nz-Mark-Y/line-following-robot/PCB Prototyping/ProposedCircuit.JPG

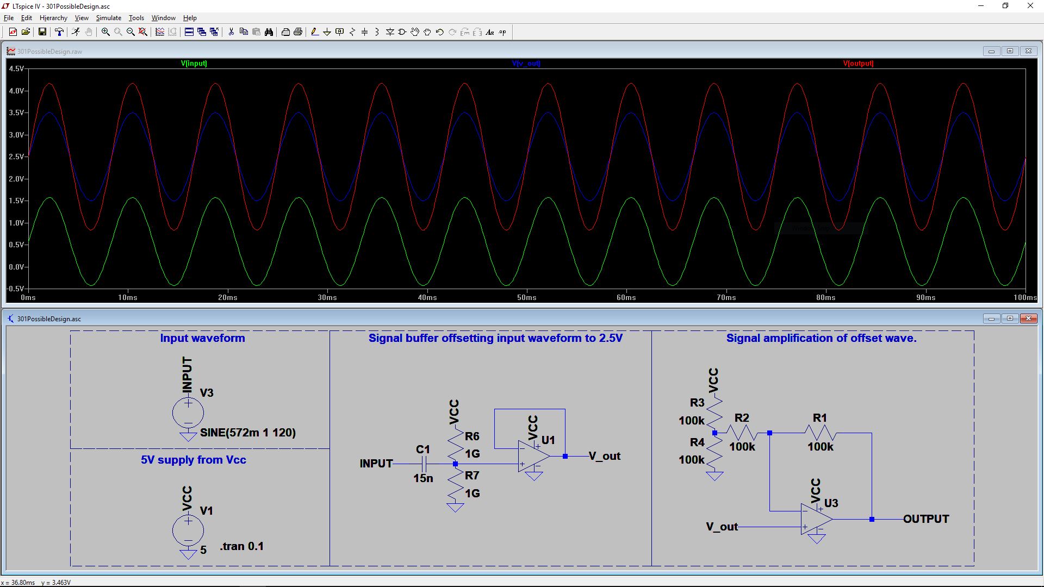
PCB Prototyping/ProposedCircuit.JPG
