nz-Mark-Y/line-following-robot/PCB Prototyping/Faulty Proposed Circuit.JPG

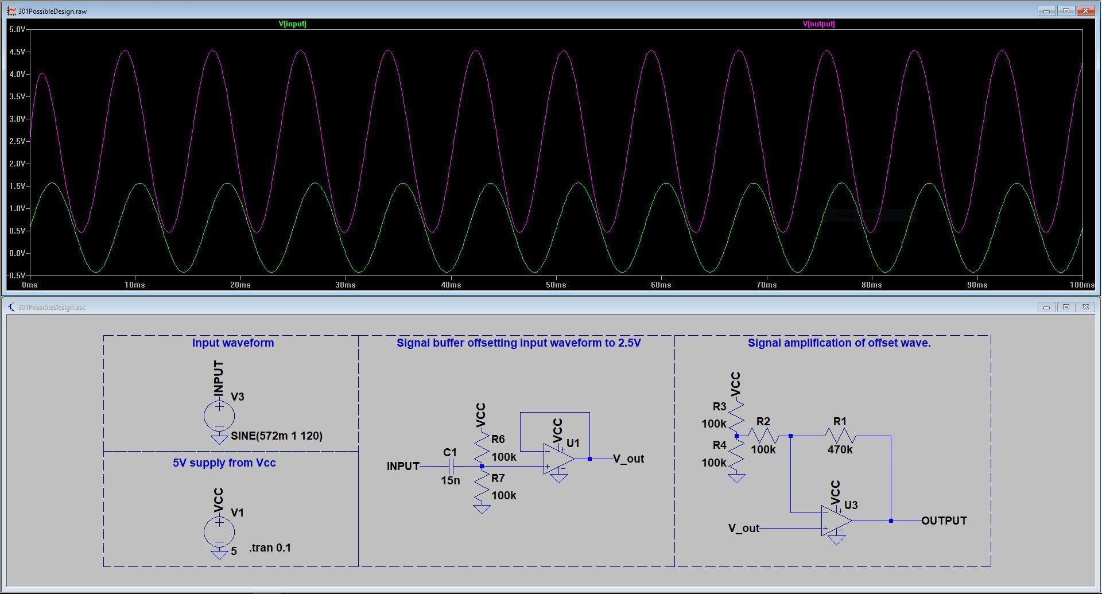
PCB Prototyping/Faulty Proposed Circuit.JPG
