nz-Mark-Y/line-following-robot/README.md

# README #

### What is this repository for? ###

* Line following robot with light sensing line tracking capabilities, to traverse a maze projected onto a surface.
* Prototype version complete

### Who do I talk to? ###

* Sylvain Bechet
* Savi Mohan
* Ira Syamira 
* Mark Yep
