nz-Mark-Y/line-following-robot/CS301_Class.cydsn/ComponentUpdateLog.txt

Last Modified Date & Time: 08/16/2017 14:08:49

CS301_Class: CS301_Class.cydwr
	cy_boot [v5.40] to [v5.60]
	LIN_Dynamic [v3.40] to [v4.0]

CS301_Class: TopDesign.cysch
	Timer_TS [v2.70] to [v2.80]
	USBUART [v3.0] to [v3.20]

Last Modified Date & Time: 08/18/2017 10:47:55

CS301_Class: TopDesign.cysch
	Timer_TS [v2.70] to [v2.70]
	USBUART [v3.0] to [v3.0]

CS301_Class: CS301_Class.cydwr
	cy_boot [v4.20] to [v5.40]
