nz-Mark-Y/line-following-robot/PCB Prototyping/Light Sensor PCB.PDF

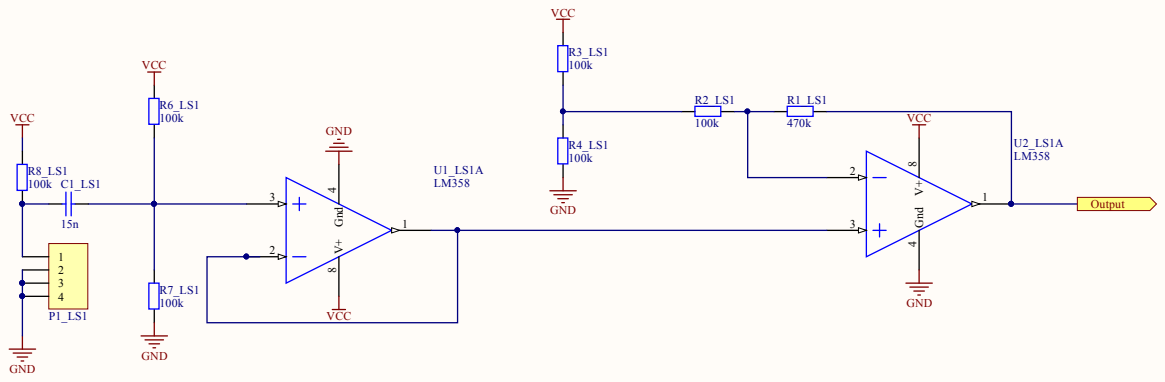
[picture p14: page 1]

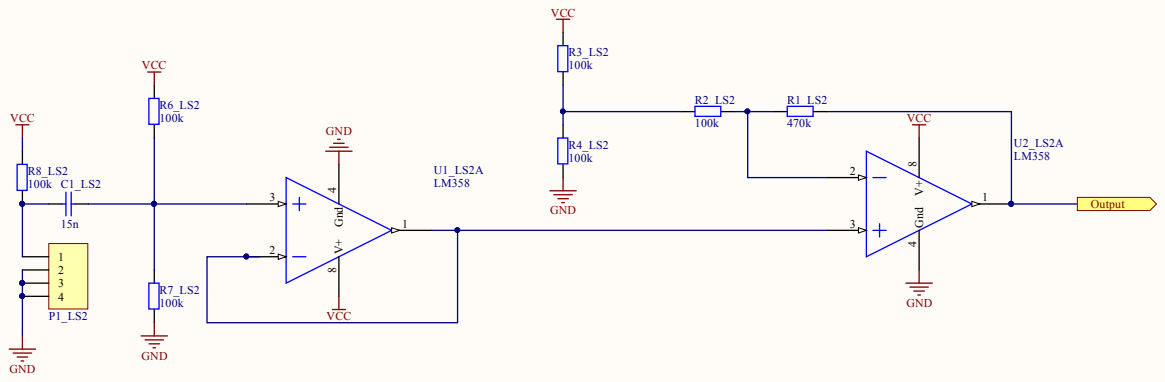
[picture p15: page 2]

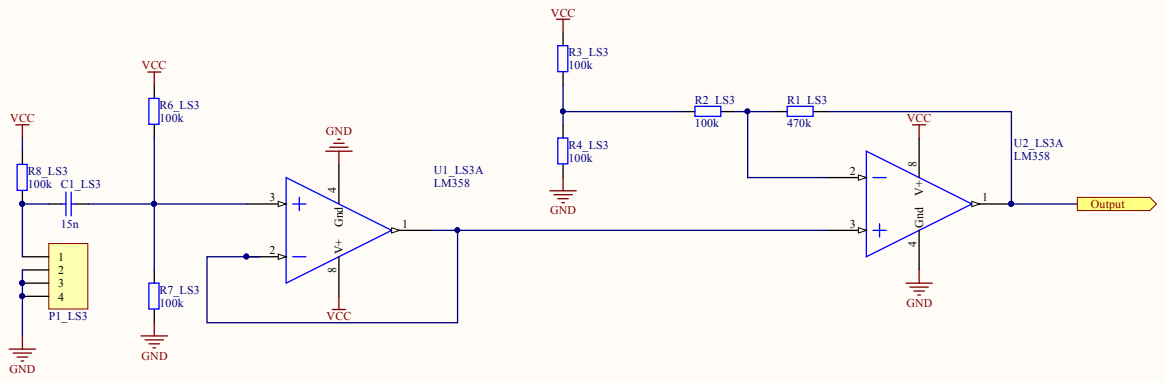
[picture p16: page 3]

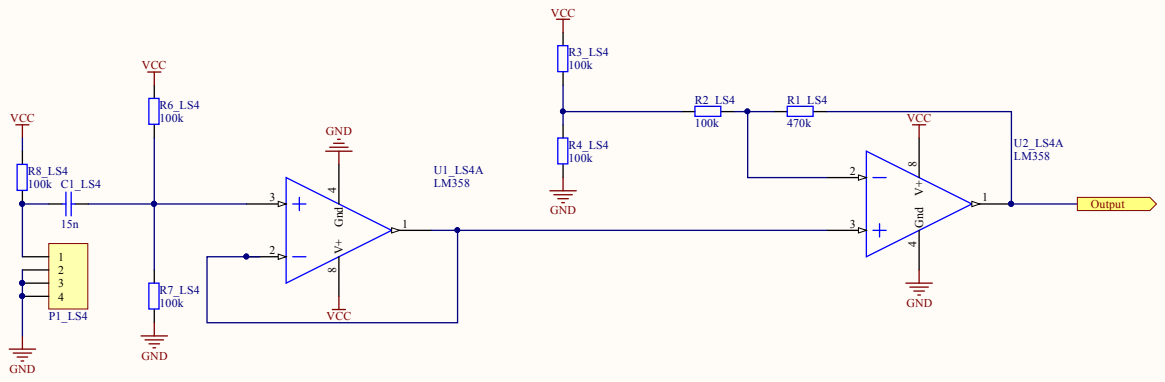
[picture p17: page 4]

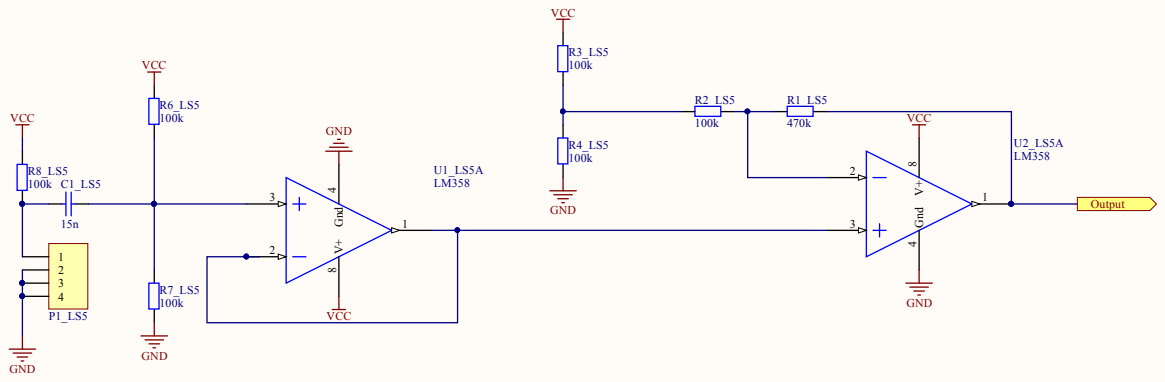
[picture p18: page 5]

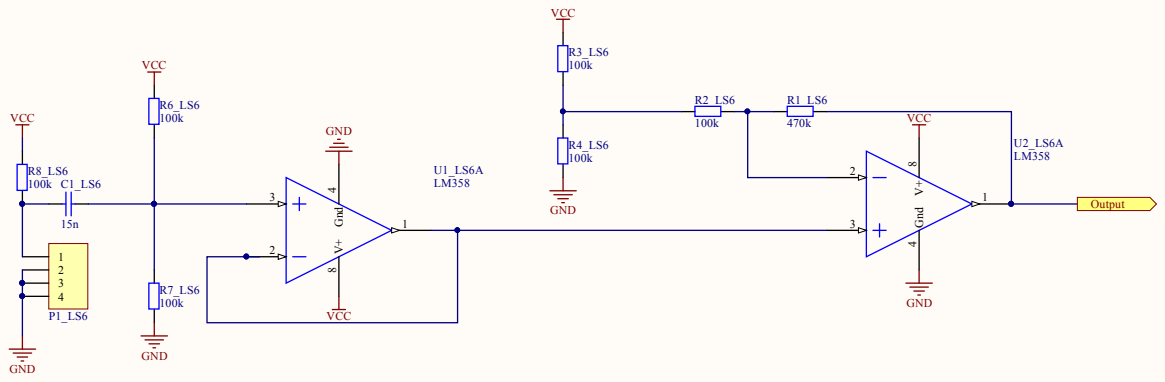
[picture p19: page 6]

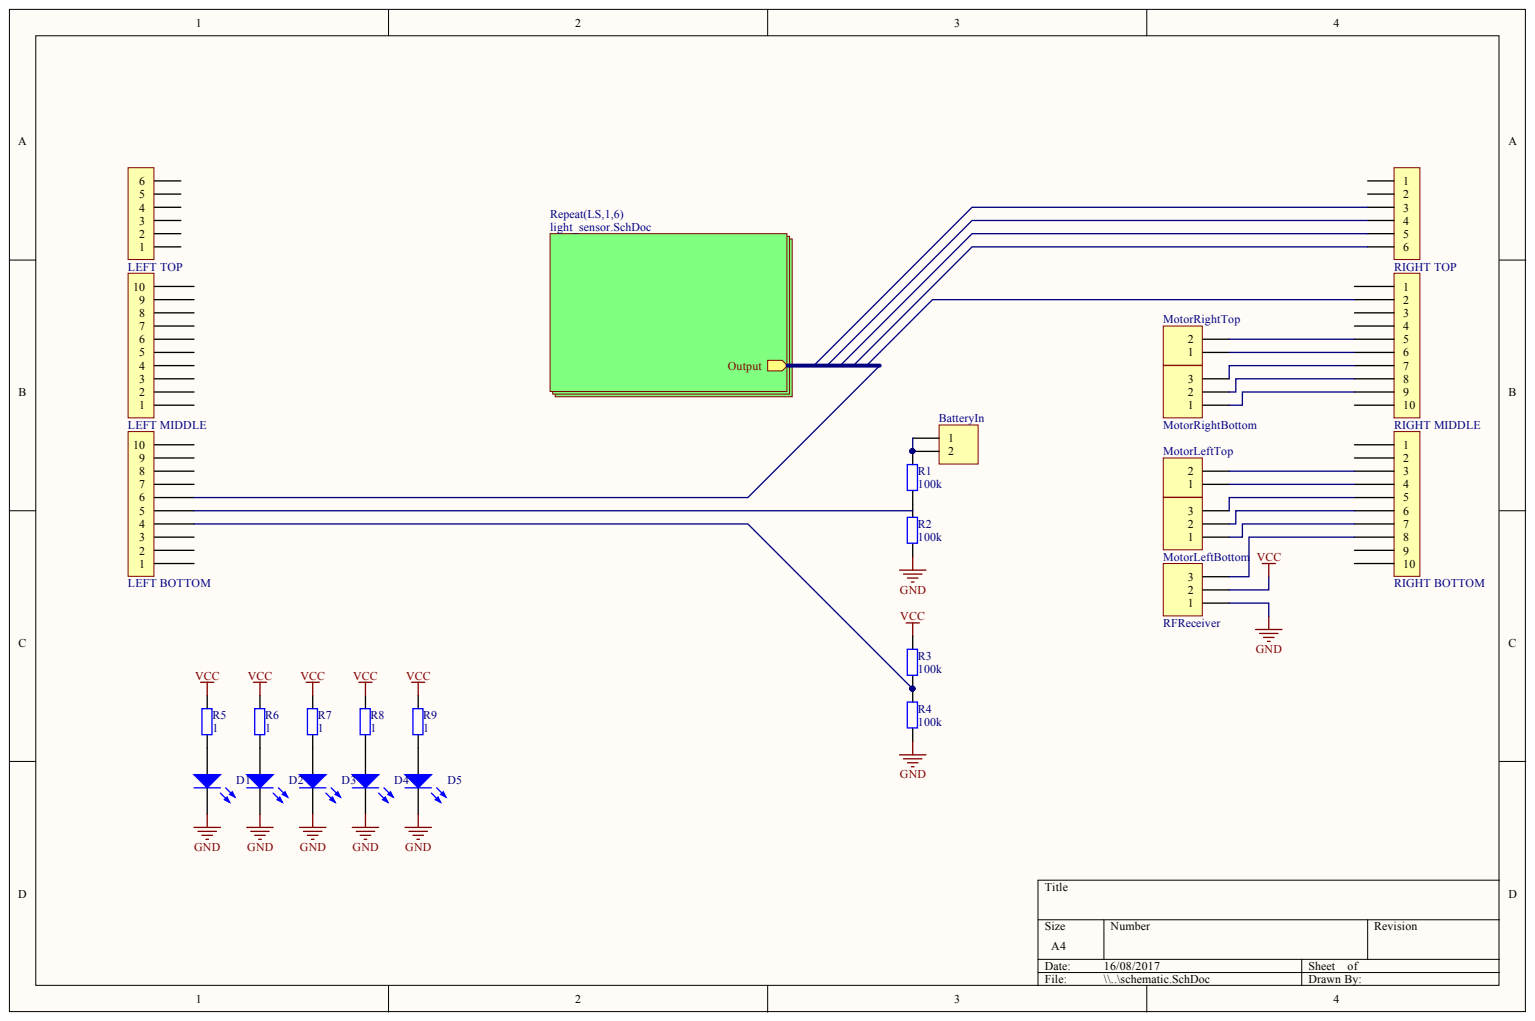
[picture p20: page 7]

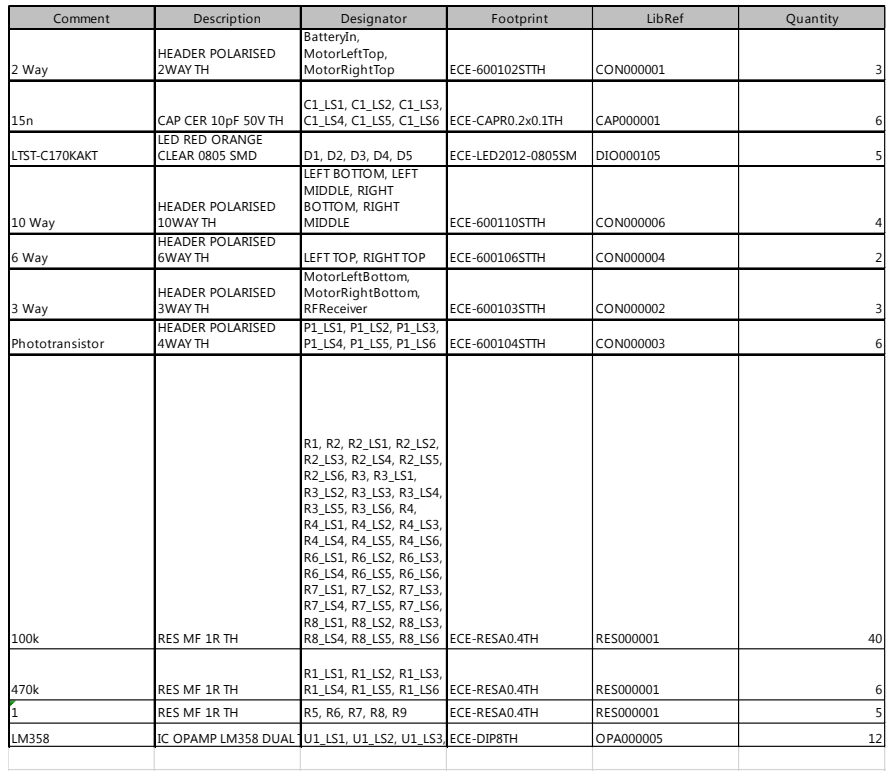
[picture p21: page 8]

Comment | Description | Designator | Footprint | LibRef | Quantity

2 Way | HEADER POLARISED 2WAY TH | BatteryIn, MotorLeftTop, MotorRightTop | ECE-600102STTH | CON000001 | 3

15n | CAP CER 10pF 50V TH | C1_LS1, C1_LS2, C1_LS3, C1_LS4, C1_LS5, C1_LS6 | ECE-CAPR0.2x0.1TH | CAP000001 | 6

LTST-C170KAKT | LED RED ORANGE CLEAR 0805 SMD | D1, D2, D3, D4, D5 | ECE-LED2012-0805SM | DIO000105 | 5

10 Way | HEADER POLARISED 10WAY TH | LEFT BOTTOM, LEFT MIDDLE, RIGHT BOTTOM, RIGHT MIDDLE | ECE-600110STTH | CON000006 | 4

6 Way | HEADER POLARISED 6WAY TH | LEFT TOP, RIGHT TOP | ECE-600106STTH | CON000004 | 2

3 Way | HEADER POLARISED 3WAY TH | MotorLeftBottom, MotorRightBottom, RFReceiver | ECE-600103STTH | CON000002 | 3

Phototransistor | HEADER POLARISED 4WAY TH | P1_LS1, P1_LS2, P1_LS3, P1_LS4, P1_LS5, P1_LS6 | ECE-600104STTH | CON000003 | 6

470k | RES MF 1R TH | R1_LS1, R1_LS2, R1_LS3, R1_LS4, R1_LS5, R1_LS6 | ECE-RESA0.4TH | RES000001 | 6

1 | RES MF 1R TH | R5, R6, R7, R8, R9 | ECE-RESA0.4TH | RES000001 | 5

LM358 | IC OPAMP LM358 DUAL TU1_LS1, U1_LS2, U1_LS3, | | ECE-D IP 8TH | OPA000005 | 12
