nz-Mark-Y/line-following-robot/cs301_altium/cs301_altium_2/cs301_YourGroupNumber.PDF

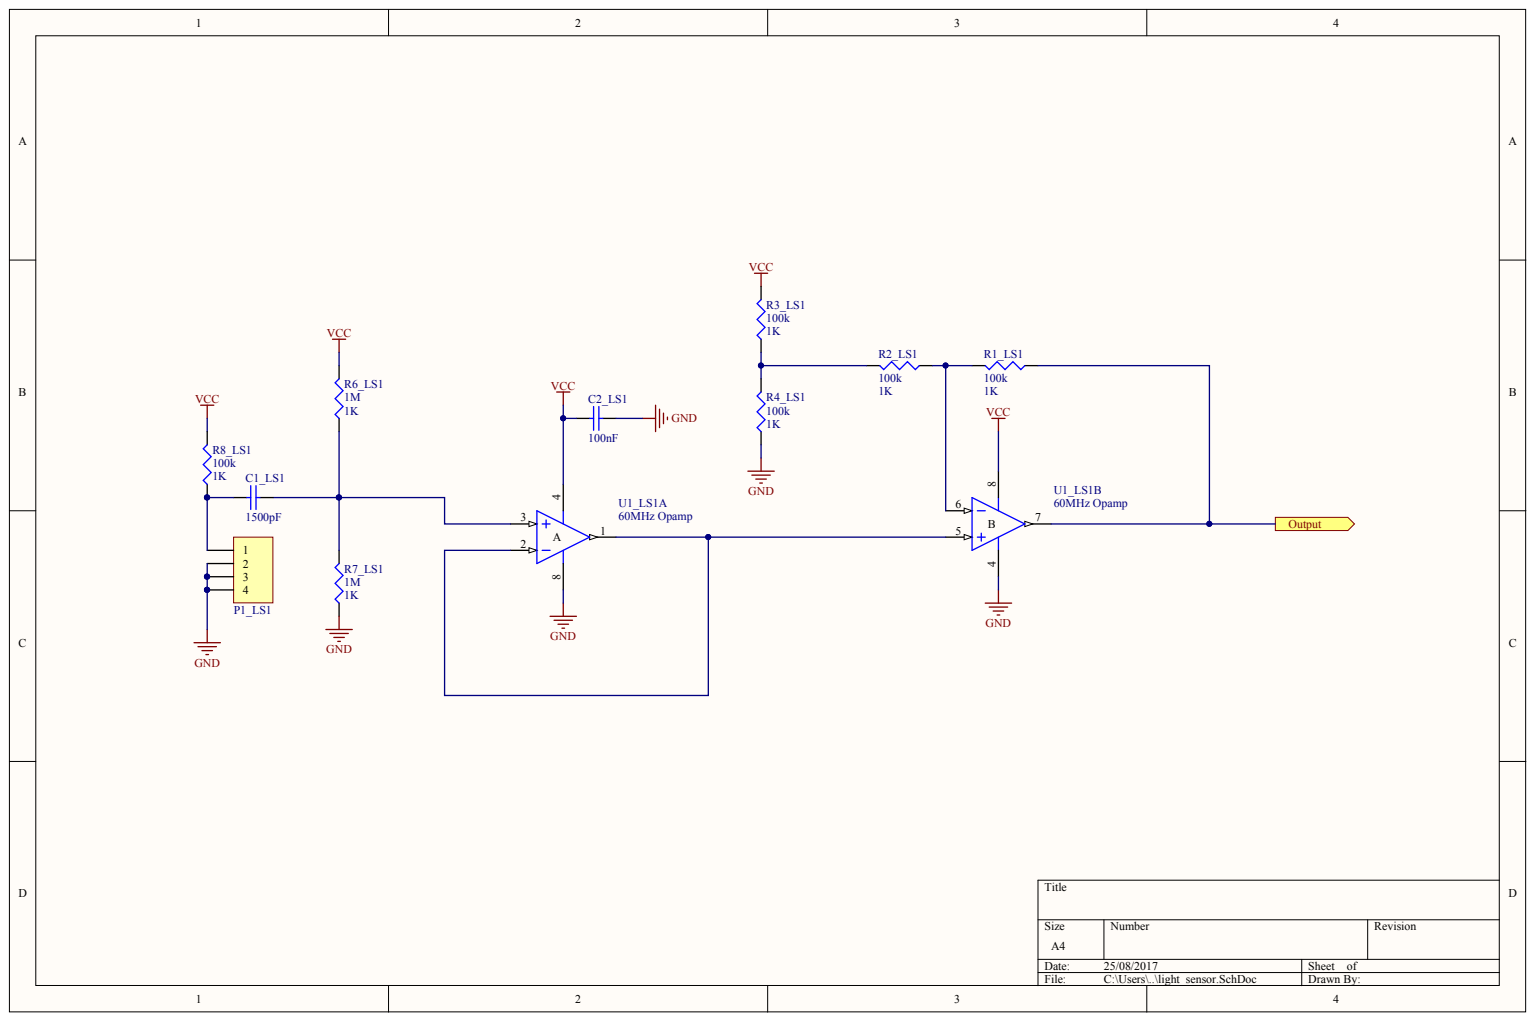
[picture p22: page 1]

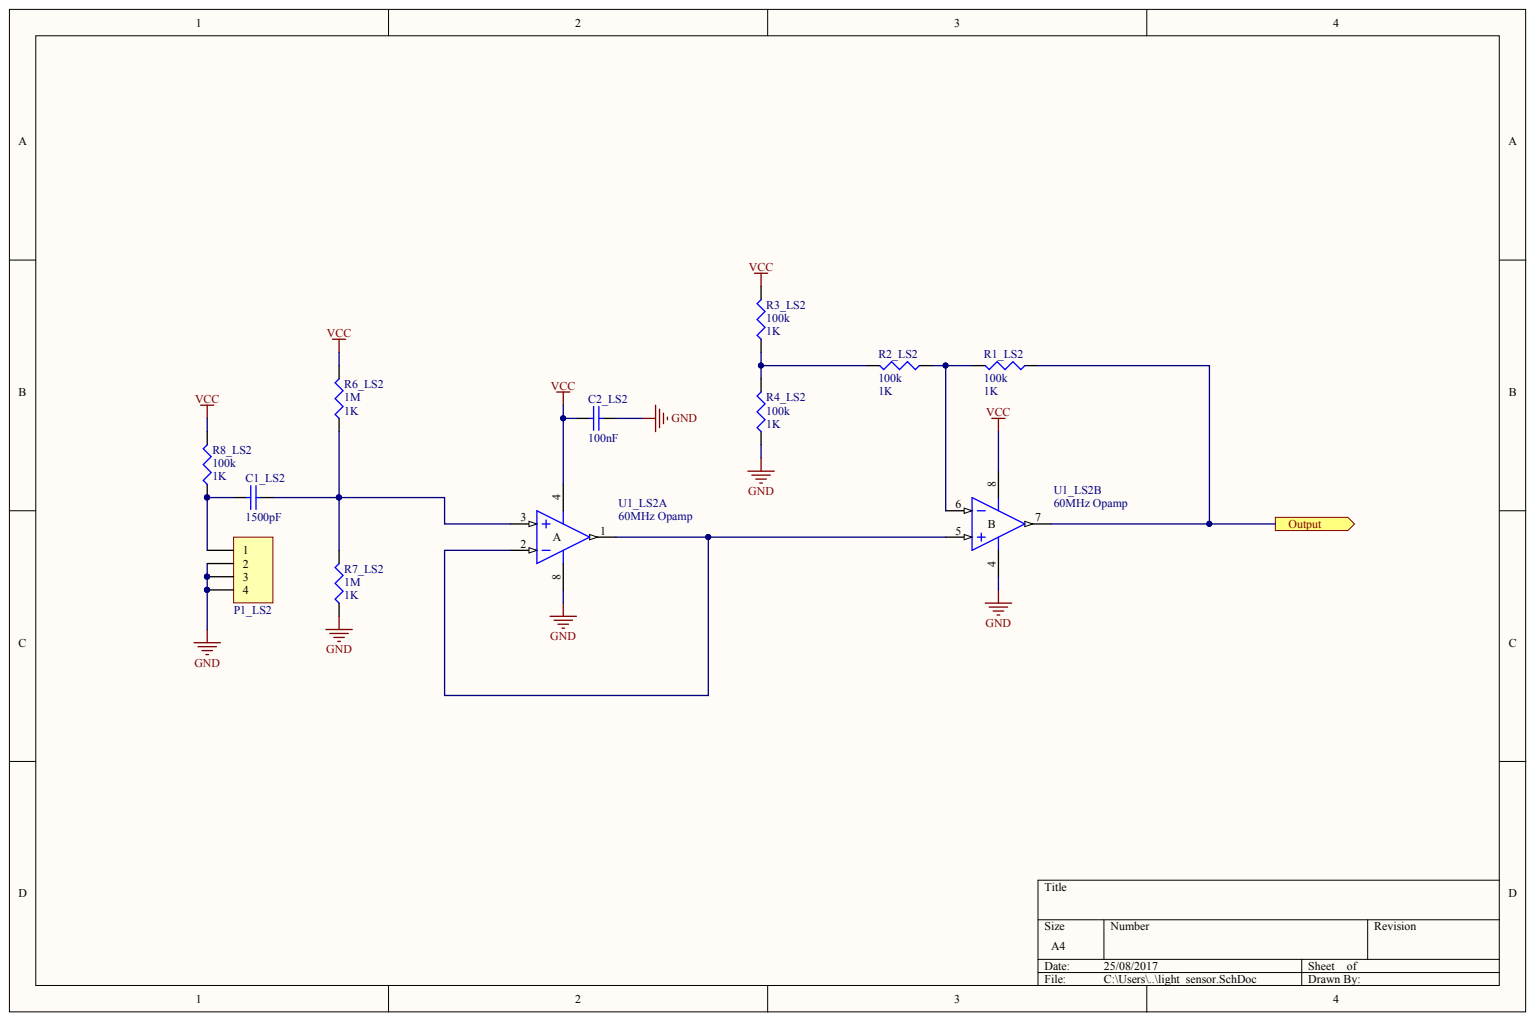
[picture p23: page 2]

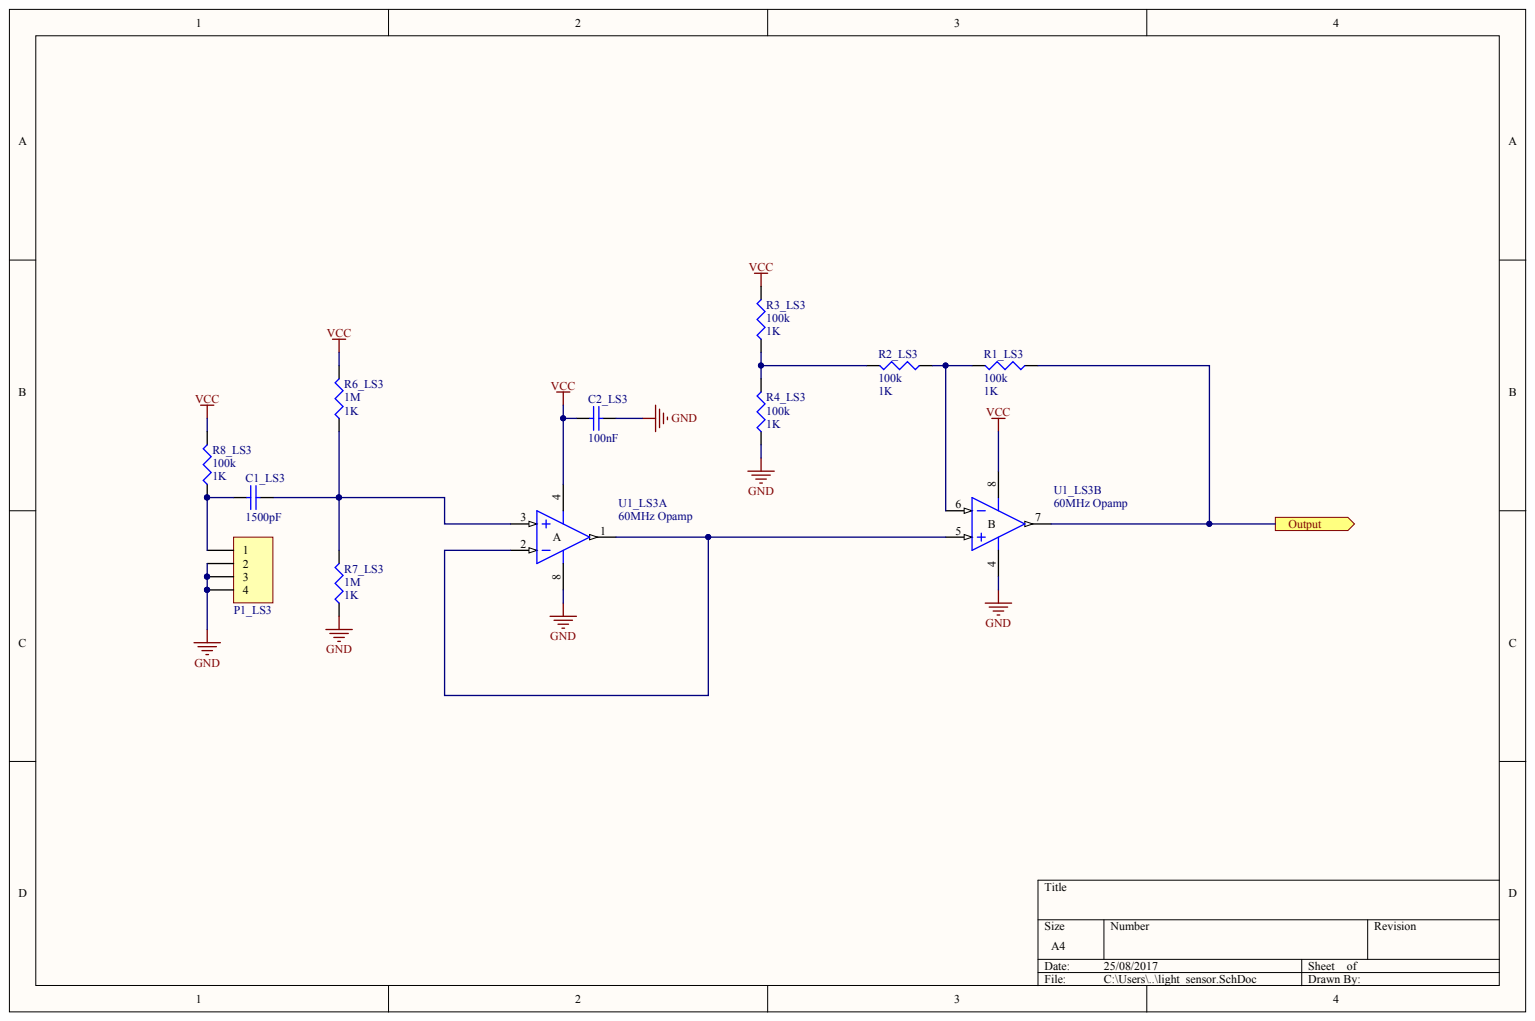
[picture p24: page 3]

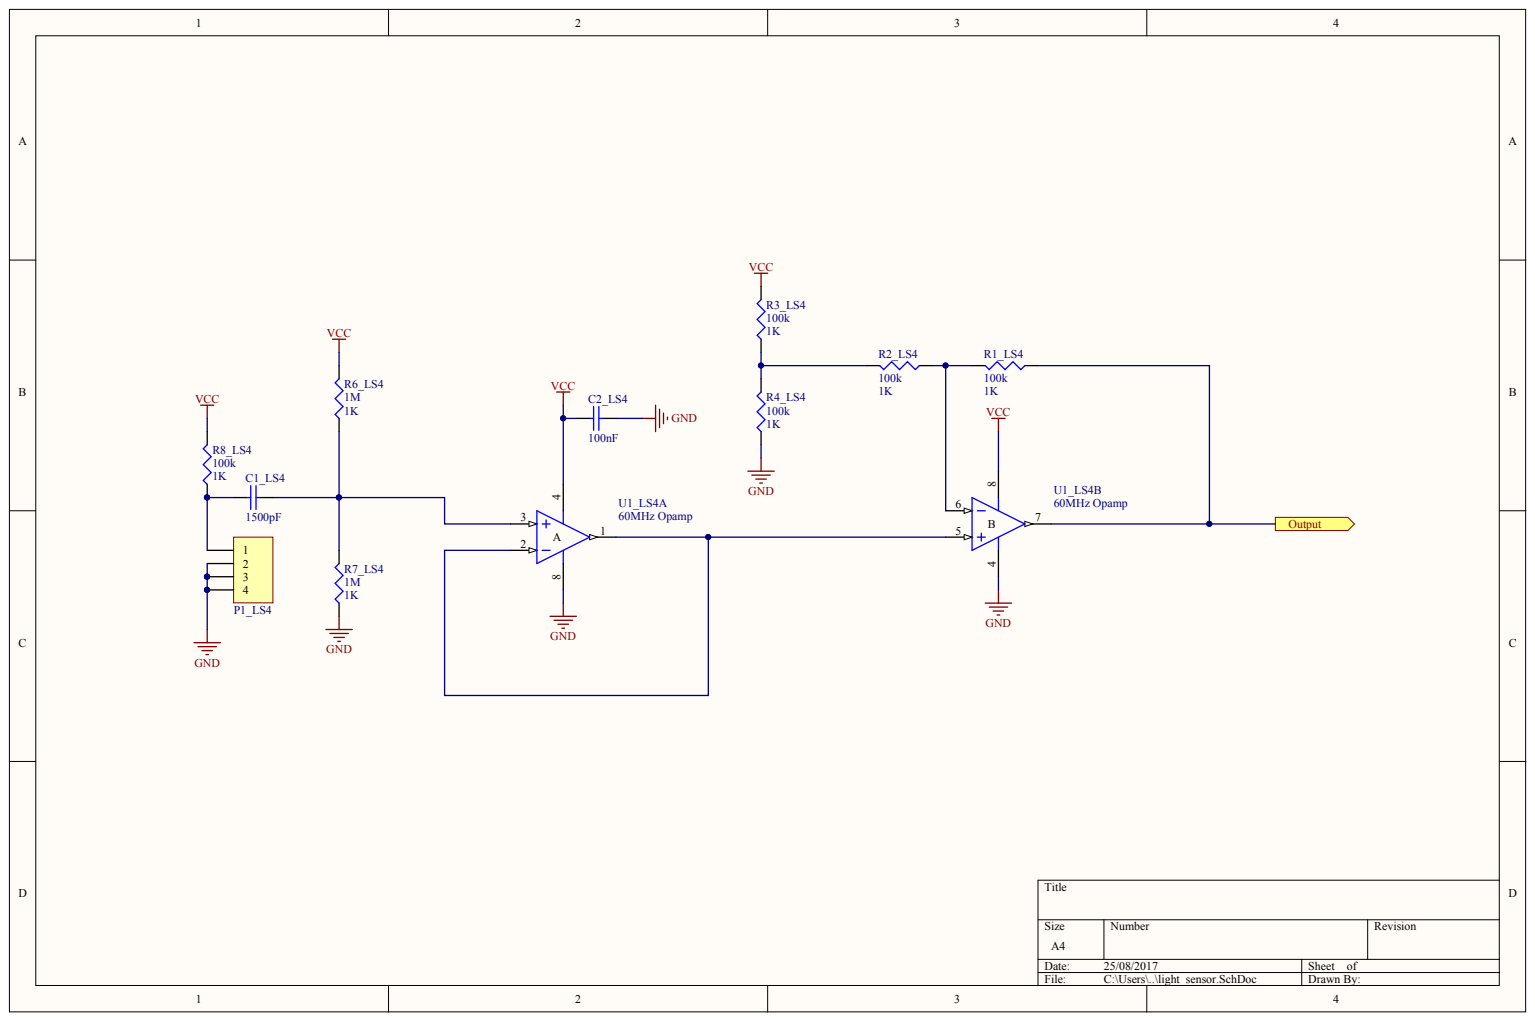
[picture p25: page 4]

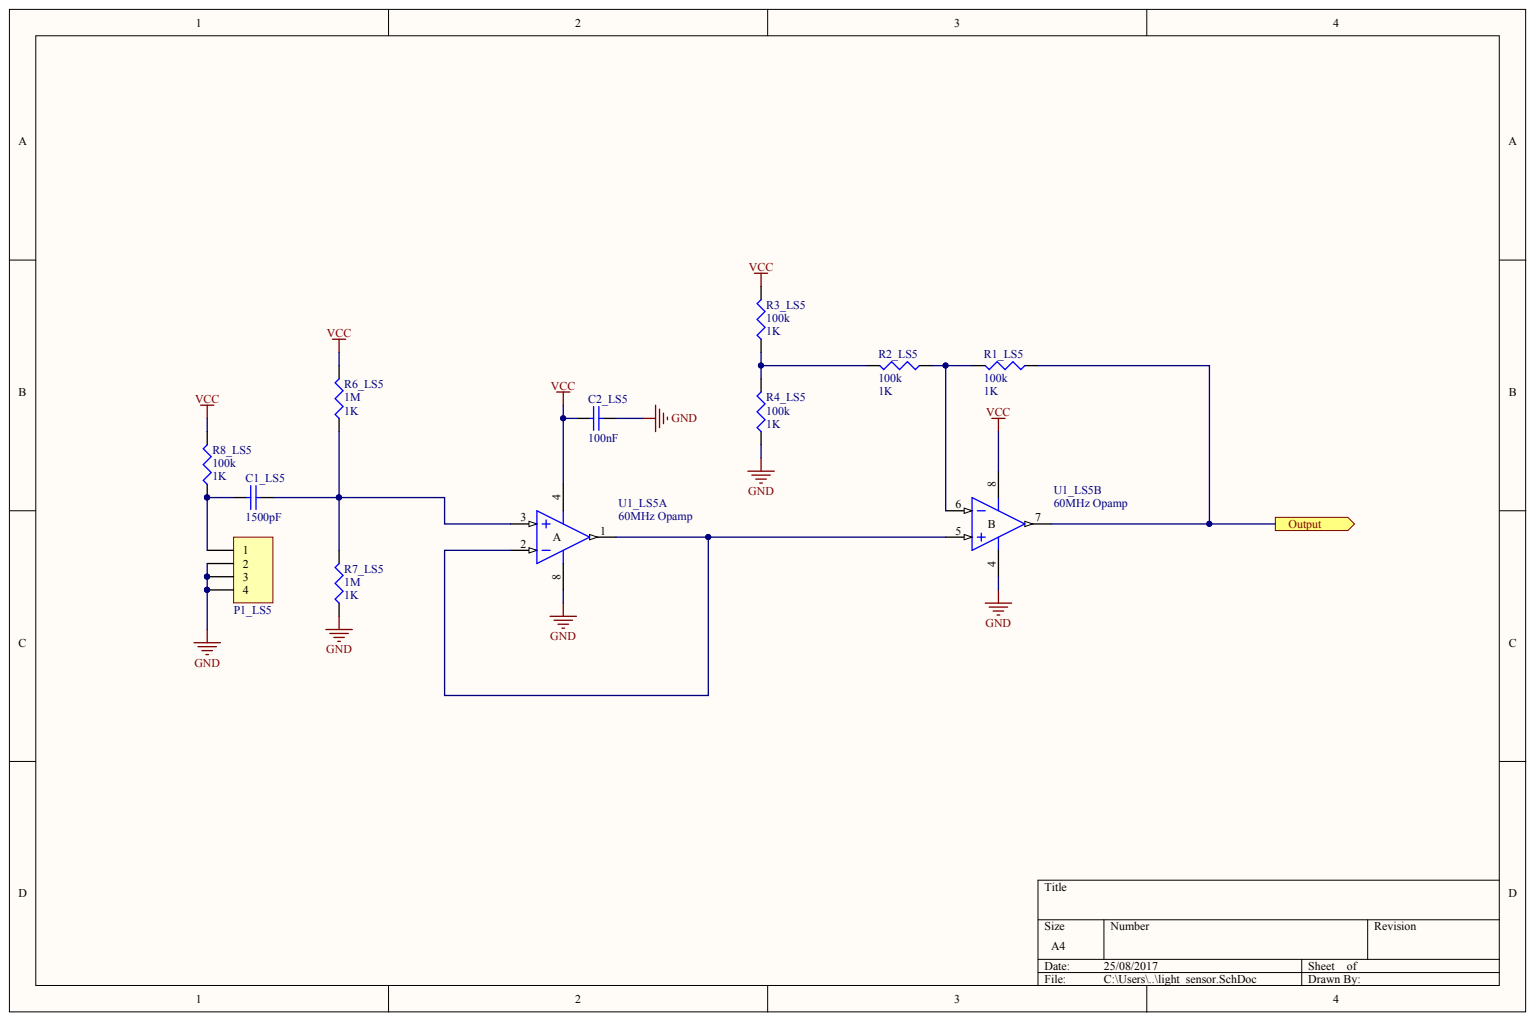
[picture p26: page 5]

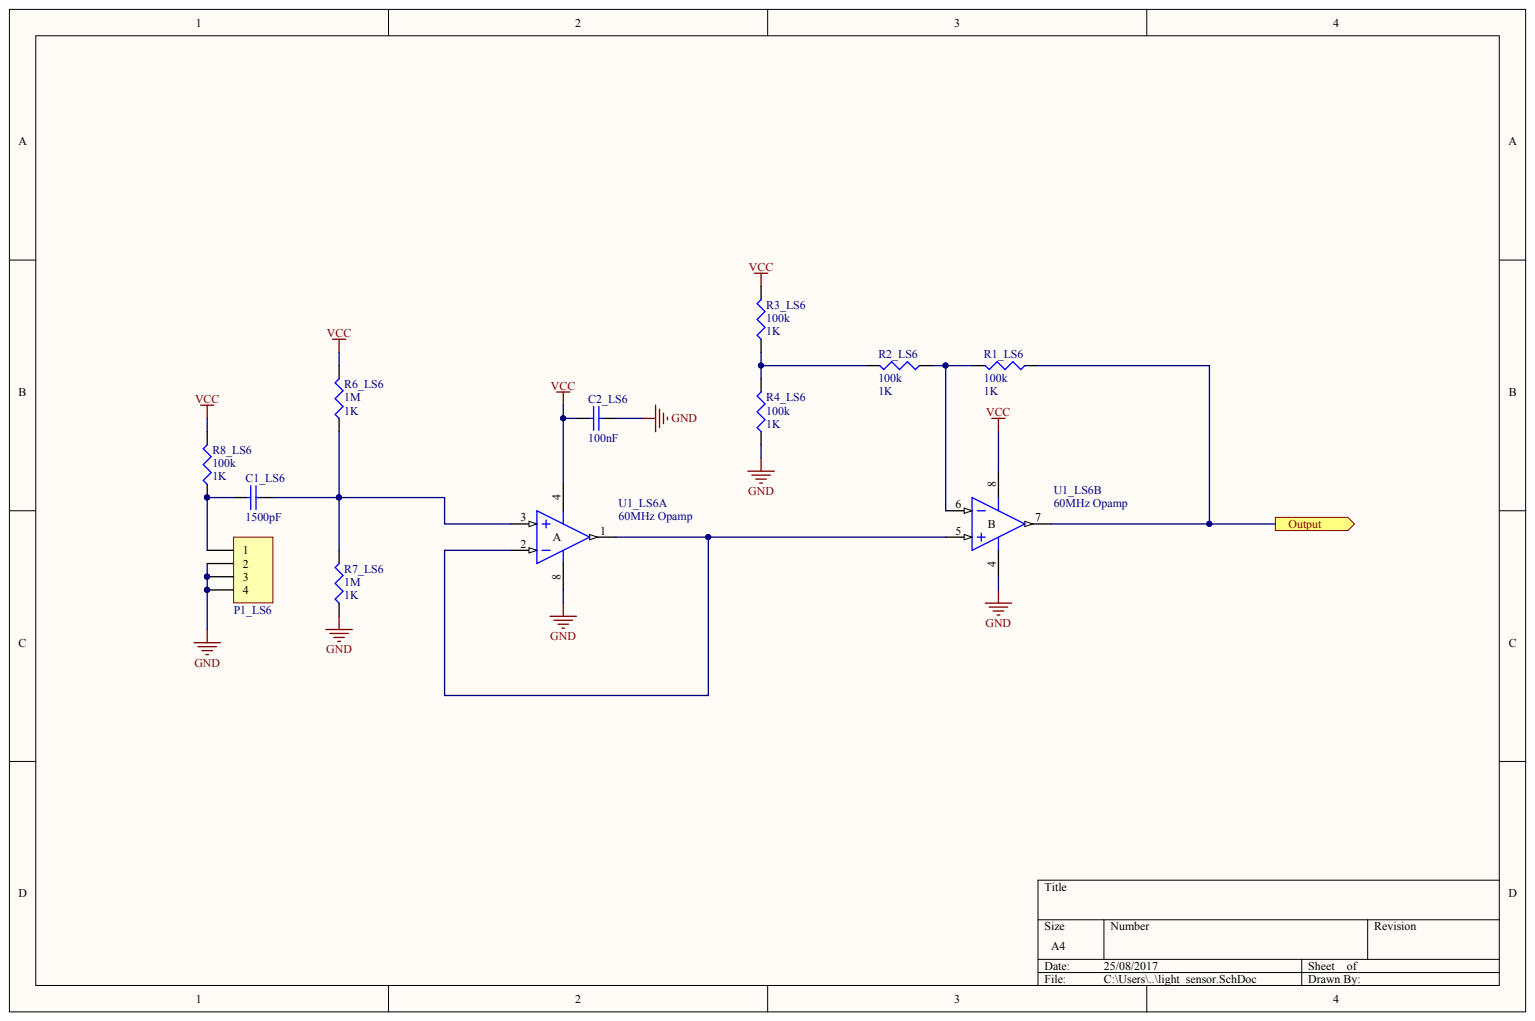
[picture p27: page 6]

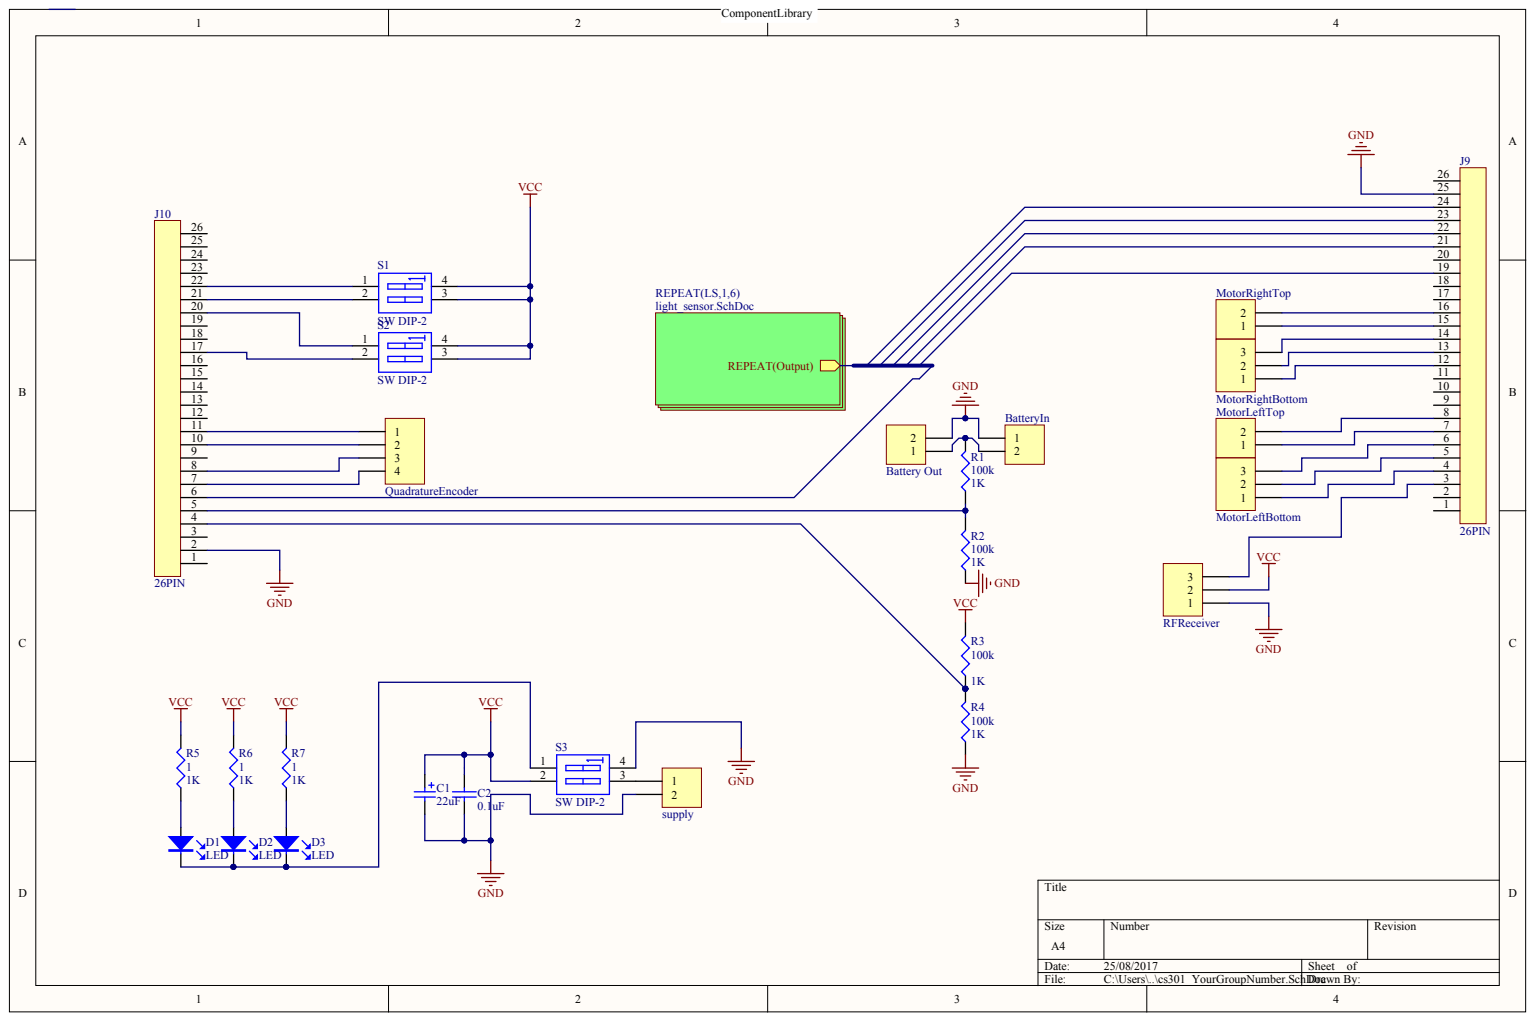
[picture p28: page 7]

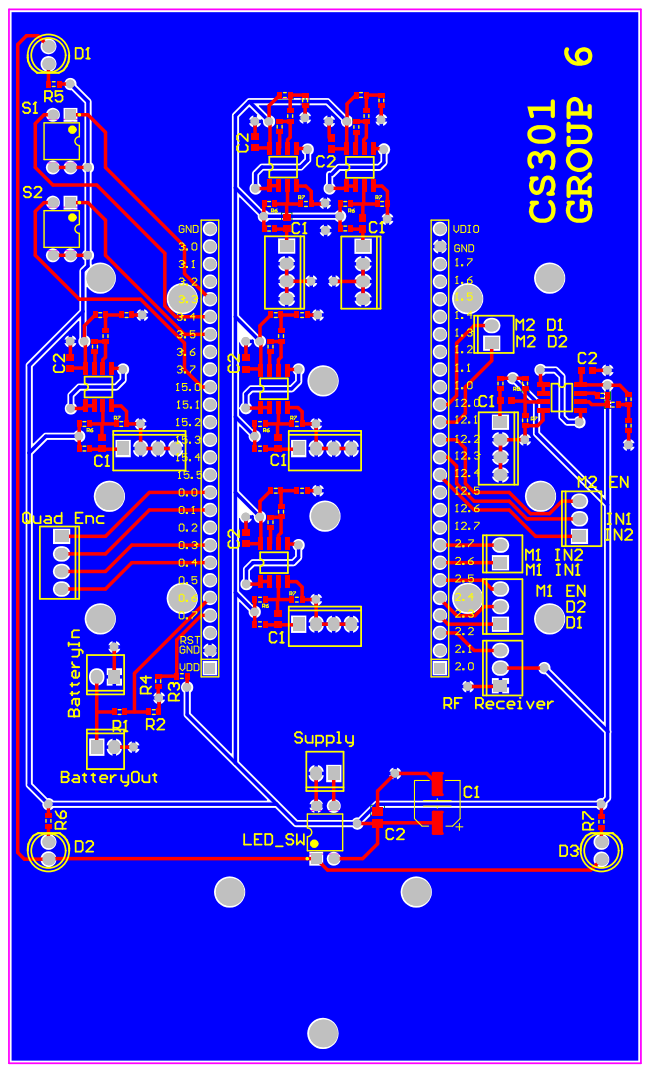
[picture p29: page 8]

# Board S
