nz-Mark-Y/line-following-robot/PCB Prototyping/301PossibleDesign.asc

C1: cap; 15n
R1: res; 100k
R2: res; 100k
R3: res; 100k
R4: res; 100k
R6: res; 1G
R7: res; 1G
U1: UniversalOpamp2
U3: UniversalOpamp2
V1: voltage; 5
V3: voltage; SINE(572m 1 120)
Named nets: VCC, 0, OUTPUT, INPUT, V_out
;tran 0.1
Input waveform
5V supply from Vcc
Signal buffer offsetting input waveform to 2.5V
Signal amplification of offset wave.
.dc V1 0 10 0.1
