nz-Mark-Y/line-following-robot/(list of files, drawings)

Other design files:
cs301_altium/ComponentLibrary/EE209-SMT.PcbLib
cs301_altium/ComponentLibrary/EE209-SMT.SchLib
cs301_altium/cs301_altium/cs301_altium.PrjPcb
cs301_altium/cs301_altium/light_sensor.SchDoc
cs301_altium/cs301_altium/pcb.PcbDoc
cs301_altium/cs301_altium/schematic.SchDoc
cs301_altium/cs301_altium_2/cs301_YourGroupNumber.PcbDoc
cs301_altium/cs301_altium_2/cs301_YourGroupNumber.PrjPCB
cs301_altium/cs301_altium_2/cs301_YourGroupNumber.SchDoc
cs301_altium/cs301_altium_2/light_sensor.SchDoc
