nz-Mark-Y/line-following-robot/CS301_Class.cydsn/map.h

/* ========================================
 *
 * Copyright YOUR COMPANY, THE YEAR
 * All Rights Reserved
 * UNPUBLISHED, LICENSED SOFTWARE.
 *
 * CONFIDENTIAL AND PROPRIETARY INFORMATION
 * WHICH IS THE PROPERTY OF your company.
 *
 * ========================================
*/

#ifndef MAP_H_INCLUDED /* include guard */
#define MAP_H_INCLUDED

#include <stdint.h>
#include <stdio.h>

int16_t map[15][19] = /*{
    
 {1,1,1,1,1,1,1,1,1,1,1,1,1,1,1,1,1,1,1},
 {1,0,0,0,0,1,0,0,0,0,0,0,0,0,0,0,0,0,1},
 {1,1,1,1,0,0,0,1,1,0,1,1,0,1,0,1,1,0,1},
 {1,0,0,0,0,1,1,0,0,0,1,0,0,0,0,1,1,0,1},
 {1,1,1,1,0,0,0,0,1,1,1,0,1,1,0,0,0,0,1},
 {1,0,0,0,0,1,0,1,1,0,0,0,1,0,0,1,0,1,1},
 {1,1,0,1,1,1,0,0,0,0,1,0,0,0,1,1,0,1,1},
 {1,0,0,0,0,1,0,1,1,1,1,0,1,0,1,0,1,0,1},
 {1,0,1,1,0,0,0,0,1,0,0,0,1,0,1,0,1,0,1},
 {1,0,0,1,1,1,1,0,1,0,1,0,1,0,0,0,0,0,1},
 {1,0,1,0,0,0,1,0,0,0,1,0,1,0,1,1,1,1,1},
 {1,0,0,1,0,1,0,0,1,0,0,0,0,0,1,0,0,0,1},
 {1,0,1,1,0,1,1,0,1,1,1,0,1,0,0,0,1,0,1},
 {1,0,0,0,0,0,0,0,0,0,0,0,0,0,1,0,0,0,1},
 {1,1,1,1,1,1,1,1,1,1,1,1,1,1,1,1,1,1,1}
 };
*/
{
	{1,1,1,1,1,1,1,1,1,1,1,1,1,1,1,1,1,1,1},
    {1,0,1,0,0,0,0,0,0,0,0,0,0,0,0,0,0,0,1},
    {1,0,1,0,1,0,1,1,1,0,1,1,1,0,1,1,1,0,1},
    {1,0,1,0,1,0,1,0,0,0,0,0,1,0,0,0,0,0,1},
    {1,0,1,0,1,0,0,0,1,1,1,0,1,0,1,1,1,0,1},
    {1,0,0,0,0,0,1,0,0,0,1,0,1,0,0,0,0,0,1},
    {1,1,1,0,1,1,1,0,1,0,1,0,1,0,1,1,1,0,1},
    {1,0,0,0,0,0,0,0,1,0,0,0,0,0,1,0,0,0,1},
    {1,1,1,0,1,0,1,0,1,1,1,0,1,0,1,0,1,1,1},
    {1,0,0,0,1,0,1,0,0,0,0,0,0,0,0,0,0,0,1},
    {1,0,1,1,1,0,1,0,1,0,1,0,1,1,1,1,1,0,1},
    {1,0,0,0,0,0,0,0,1,0,0,0,0,0,1,0,0,0,1},
    {1,0,1,1,1,1,1,1,1,0,1,1,1,1,1,0,1,1,1},
    {1,0,0,0,0,0,0,0,0,0,0,0,0,0,0,0,0,0,1},
    {1,1,1,1,1,1,1,1,1,1,1,1,1,1,1,1,1,1,1},
	};
    
int16_t food_list[5][2]= {{4,5},{3,11},{15,12},{17,4},{11,6}};

int16_t start_X = 1;
int16_t start_Y = 1;

#endif /* MAP_H_ */
/* [] END OF FILE */
