nz-Mark-Y/line-following-robot/CS301_Class.cydsn/vars.h

/* ========================================
 *
 * Copyright Univ of Auckland, 2016
 * All Rights Reserved
 * UNPUBLISHED, LICENSED SOFTWARE.
 *
 * CONFIDENTIAL AND PROPRIETARY INFORMATION
 * WHICH IS THE PROPERTY OF your company.
 *
 * ========================================
*/

#include <project.h>
#include "defines.h"
//* ========================================
uint8 ts = 0;
uint16 ts_enc = 0;
uint16 ts_update = 0;
uint16 ts_speed = 0;
uint16 ts_display = 0;

uint8 flag_ts_enc = 0;
uint8 flag_ts_update = 0;
uint8 flag_ts_speed = 0;
uint8 flag_ts_display = 0;

uint8 flag_rx = 0;
uint8 flag_packet = 0;
uint8 flag_KB_string = 0;

uint8 dataready_flag = 0;

uint8 flag_rf_transmission_active = UNKNOWN; // [TRUE if receieving data, FALSE is not, UNKNOWN at startup]
//* ========================================
typedef struct data_main {
	int8            rssi;	
    uint8           index;			// index number of packet. incremented number
	int16			robot_xpos;	 	// 
	int16			robot_ypos;		//
    int16         robot_orientation;
	int16			g0_xpos;		//
	int16			g0_ypos;		//
	int16			g0_speed;		//
	int16		g0_direction;	//
	int16			g1_xpos;		//
	int16			g1_ypos;		//
	int16			g1_speed;		//
    int16		g1_direction;	//
    int16			g2_xpos;		//
    int16			g2_ypos;		//
    int16			g2_speed;		//
    int16		g2_direction;	//
} vtype1;    
struct data_main system_state;
//* ========================================


//* ========================================
/* [] END OF FILE */
