nz-Mark-Y/line-following-robot/(commit log)

2017-08-10 added psoc creater project with motor control pin assignments and ADC reading for first interview
2017-08-10 added altium files
    [cs301_altium.PrjPcb, pcb.PcbDoc, schematic.SchDoc]
2017-08-16 updates to altium and psoc creator
    [cs301_altium.PrjPcb, light_sensor.SchDoc, schematic.SchDoc]
2017-08-16 added altium pdf
    [cs301_altium.PrjPcb, light_sensor.SchDoc]
2017-08-16 fixed pwm
2017-08-17 added generated pcb file
    [cs301_altium.PrjPcb, pcb.PcbDoc, schematic.SchDoc]
2017-08-21 updates to altium
    [light_sensor.SchDoc, schematic.SchDoc]
2017-08-21 altium fixes
    [cs301_YourGroupNumber.PcbDoc, cs301_YourGroupNumber.PrjPCB, cs301_YourGroupNumber.SchDoc, light_sensor.SchDoc, pcb.PcbDoc, schematic.SchDoc]
2017-08-23 Mapped light sensor on PCB.
    [EE209-SMT.PcbLib, EE209-SMT.SchLib, cs301_YourGroupNumber.PcbDoc, cs301_YourGroupNumber.PrjPCB, cs301_YourGroupNumber.SchDoc, light_sensor.SchDoc]
2017-08-24 Light sensors mapped and measured on PCB.
    [cs301_YourGroupNumber.PcbDoc, cs301_YourGroupNumber.SchDoc, light_sensor.SchDoc]
2017-08-24 Resolved errors and mapped the rest of the components on the PCB. Need to take care of the nets and linking the Vcc.
    [cs301_YourGroupNumber.PcbDoc, cs301_YourGroupNumber.SchDoc, light_sensor.SchDoc]
2017-08-24 Finalised PCD.
    [cs301_YourGroupNumber.PcbDoc]
2017-08-24 Added PDF
    [cs301_YourGroupNumber.PrjPCB]
2017-08-28 need to print more values of struct
2017-08-28 Printing values simultaneously, not sure if correct for
    [main.c]
2017-09-10 Added check_array function to control the motor movement based on sensor 1 and 2
2017-09-11 added print statements for distance variables
2017-09-11 Separated the printing because it is very important to do so
2017-09-13 fixing the turn algortihm
    [main.c]
2017-09-14 switch for usb output
2017-09-15 Fixed timer for turns mode
    [main.c]
2017-09-26 fixes for voltage
2017-10-13 added fixes to turn
    [main.c]
2017-10-18 fixes to astar and turning
    [main.c]
2017-10-18 more turning and algorithm fixes
    [main.c]
2017-10-19 fixes to turning algorithms
    [main.c]
